pywh4taz5n/workbench-desk-robot/hardware/pcb/fabrication/drill-report.txt

Drill report for controller.kicad_pcb
Created on 2026-08-25T17:45:02

Copper Layer Stackup:
    =============================================================
    L1 :  F.Cu                      front
    L2 :  In1.Cu                    in1
    L3 :  In2.Cu                    in2
    L4 :  In3.Cu                    in3
    L5 :  In4.Cu                    in4
    L6 :  In5.Cu                    in5
    L7 :  In6.Cu                    in6
    L8 :  B.Cu                      back

Drill file 'controller-PTH.drl' contains
    plated through holes:
    =============================================================
    T1  0.300mm  0.0118"  (150 holes))
    T2  0.400mm  0.0157"  (56 holes))
    T3  1.000mm  0.0394"  (48 holes))
    T4  1.100mm  0.0433"  (32 holes))
    T5  1.200mm  0.0472"  (2 holes))
    T6  1.300mm  0.0512"  (6 holes))
    T7  1.800mm  0.0709"  (2 holes))

    Total plated holes count 296

Drill file 'controller-front-in1.drl' contains
    holes connecting layer pair: 'F.Cu and In1.Cu' (blind vias):
    =============================================================
    T1  0.150mm  0.0059"  (9 holes))
    T2  0.300mm  0.0118"  (2 holes))

    Total plated holes count 11

Drill file 'controller-front-in2.drl' contains
    holes connecting layer pair: 'F.Cu and In2.Cu' (blind vias):
    =============================================================
    T1  0.300mm  0.0118"  (1 hole)

    Total plated holes count 1

Drill file 'controller-front-in3.drl' contains
    holes connecting layer pair: 'F.Cu and In3.Cu' (blind vias):
    =============================================================
    T1  0.300mm  0.0118"  (4 holes))

    Total plated holes count 4

Drill file 'controller-NPTH.drl' contains
    unplated through holes:
    =============================================================
    T1  3.200mm  0.1260"  (4 holes))

    Total unplated holes count 4
