pywh4taz5n/workbench-desk-robot/hardware/pcb/fabrication/board-preview.png

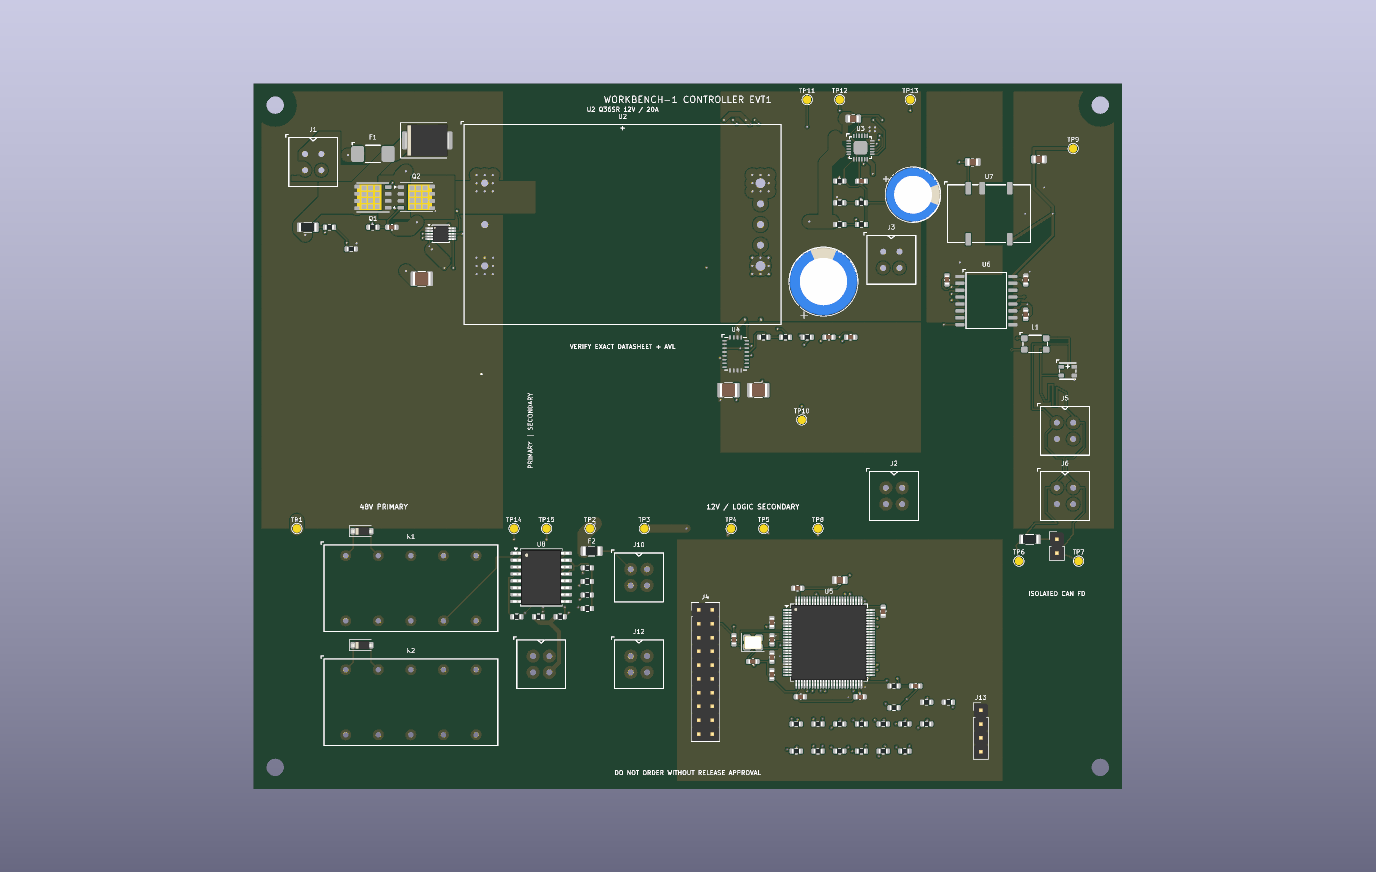
hardware/pcb/fabrication/board-preview.png
