pywh4taz5n/workbench-desk-robot/hardware/pcb/fabrication/drawings/controller-schematic.pdf

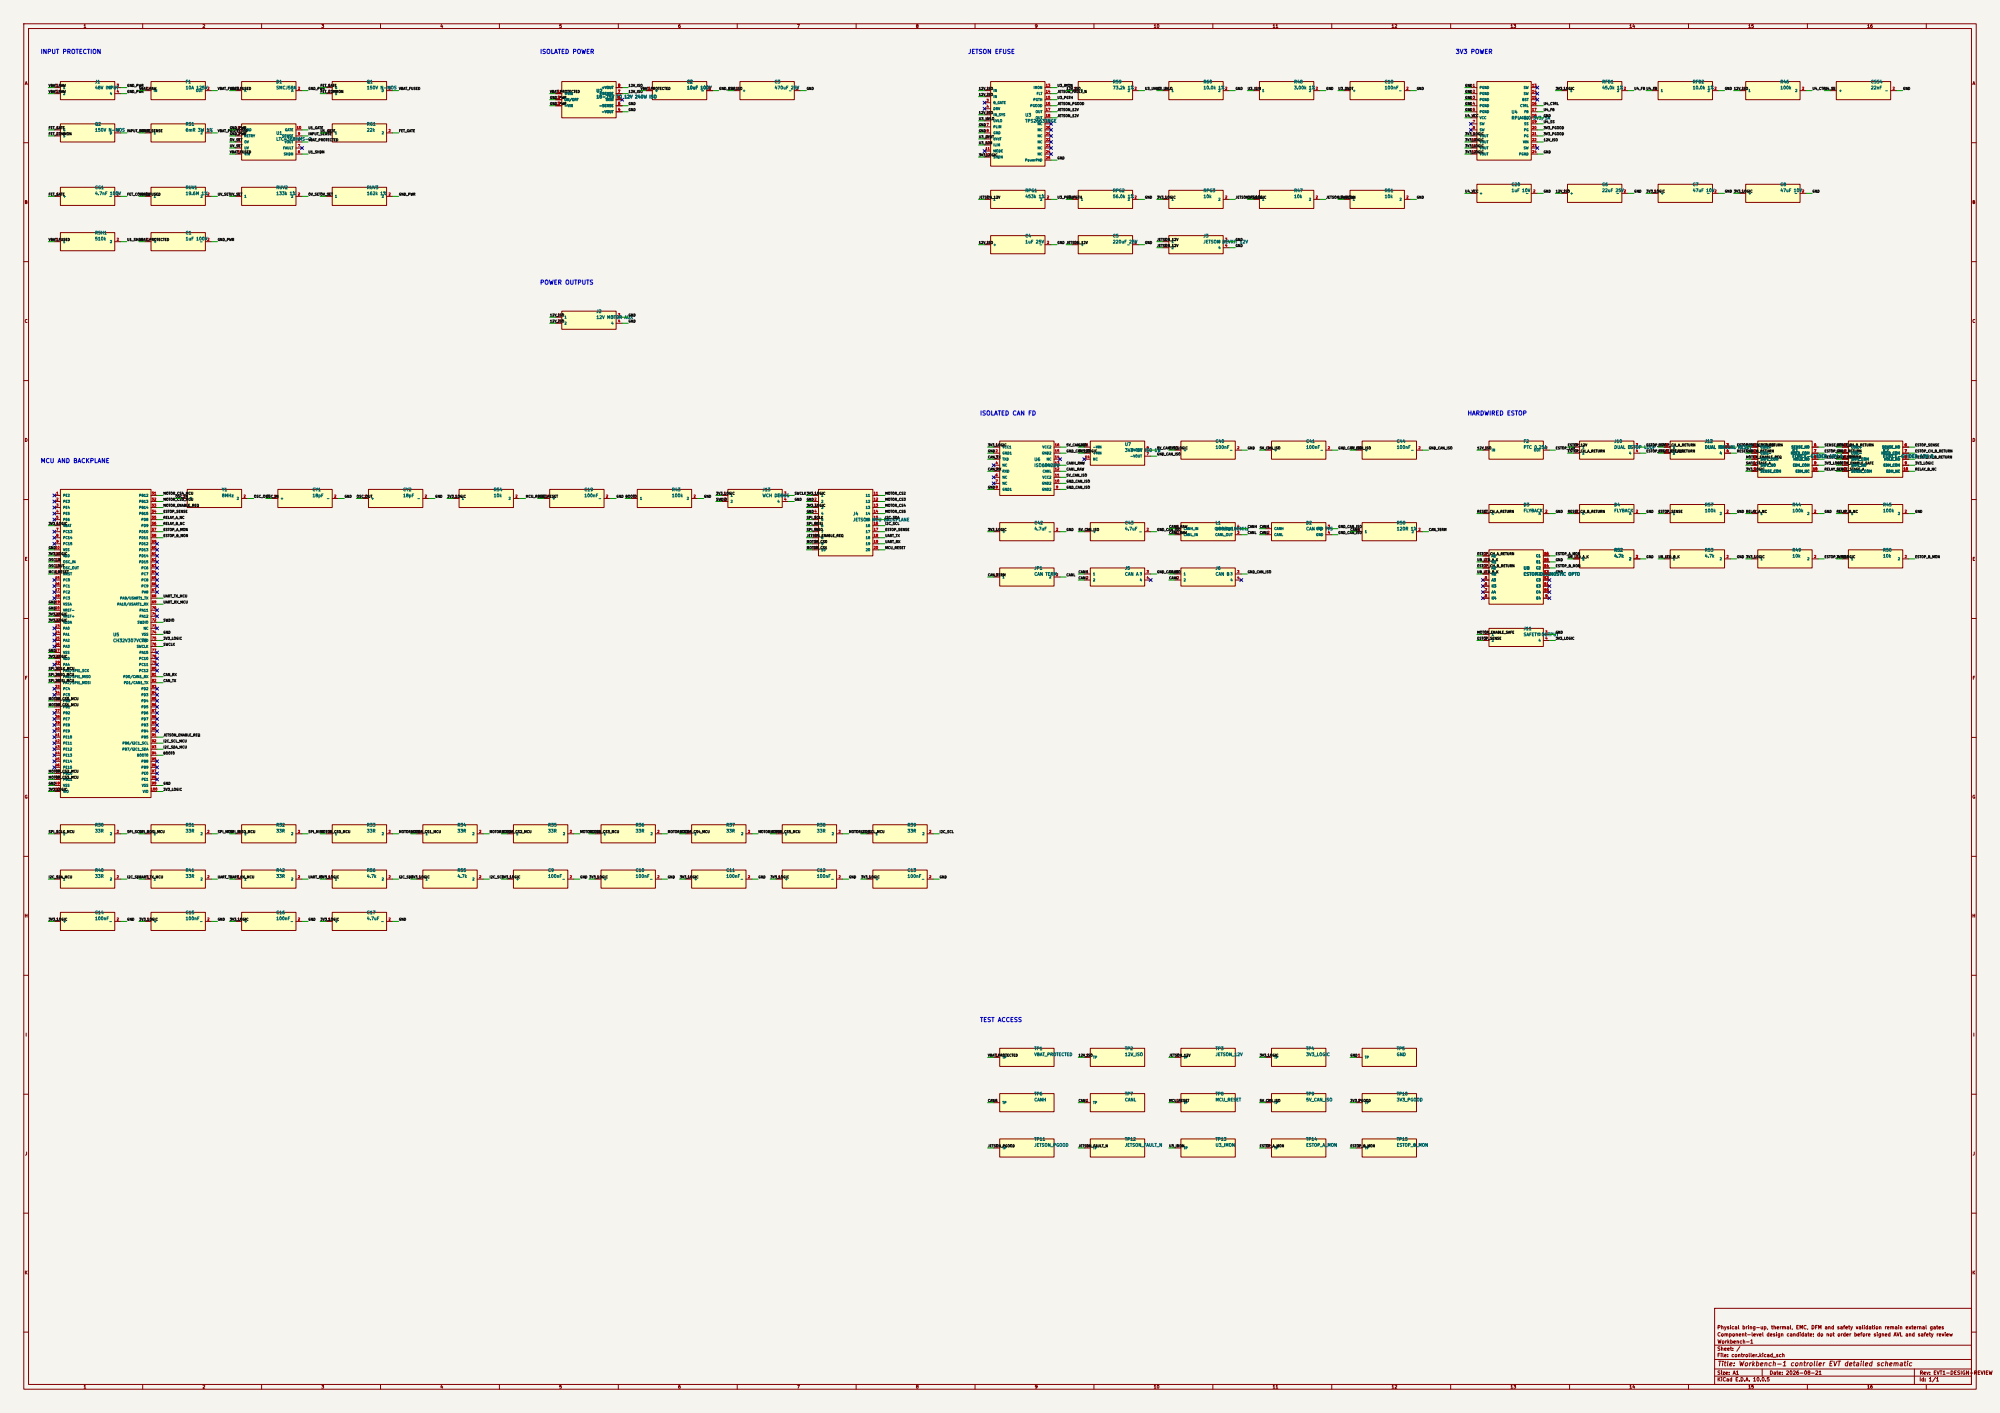
[picture p2: page 1]

Physical bring-up, thermal, EMC, DFM and safety validation remain external gates
Component-level design candidate; do not order before signed AVL and safety review
Workbench-1
Sheet: /
File: controller.kicad_sch
Title: Workbench-1 controller EVT detailed schematic
