pywh4taz5n/workbench-desk-robot/hardware/pcb/fabrication/drawings/routing-review.pdf

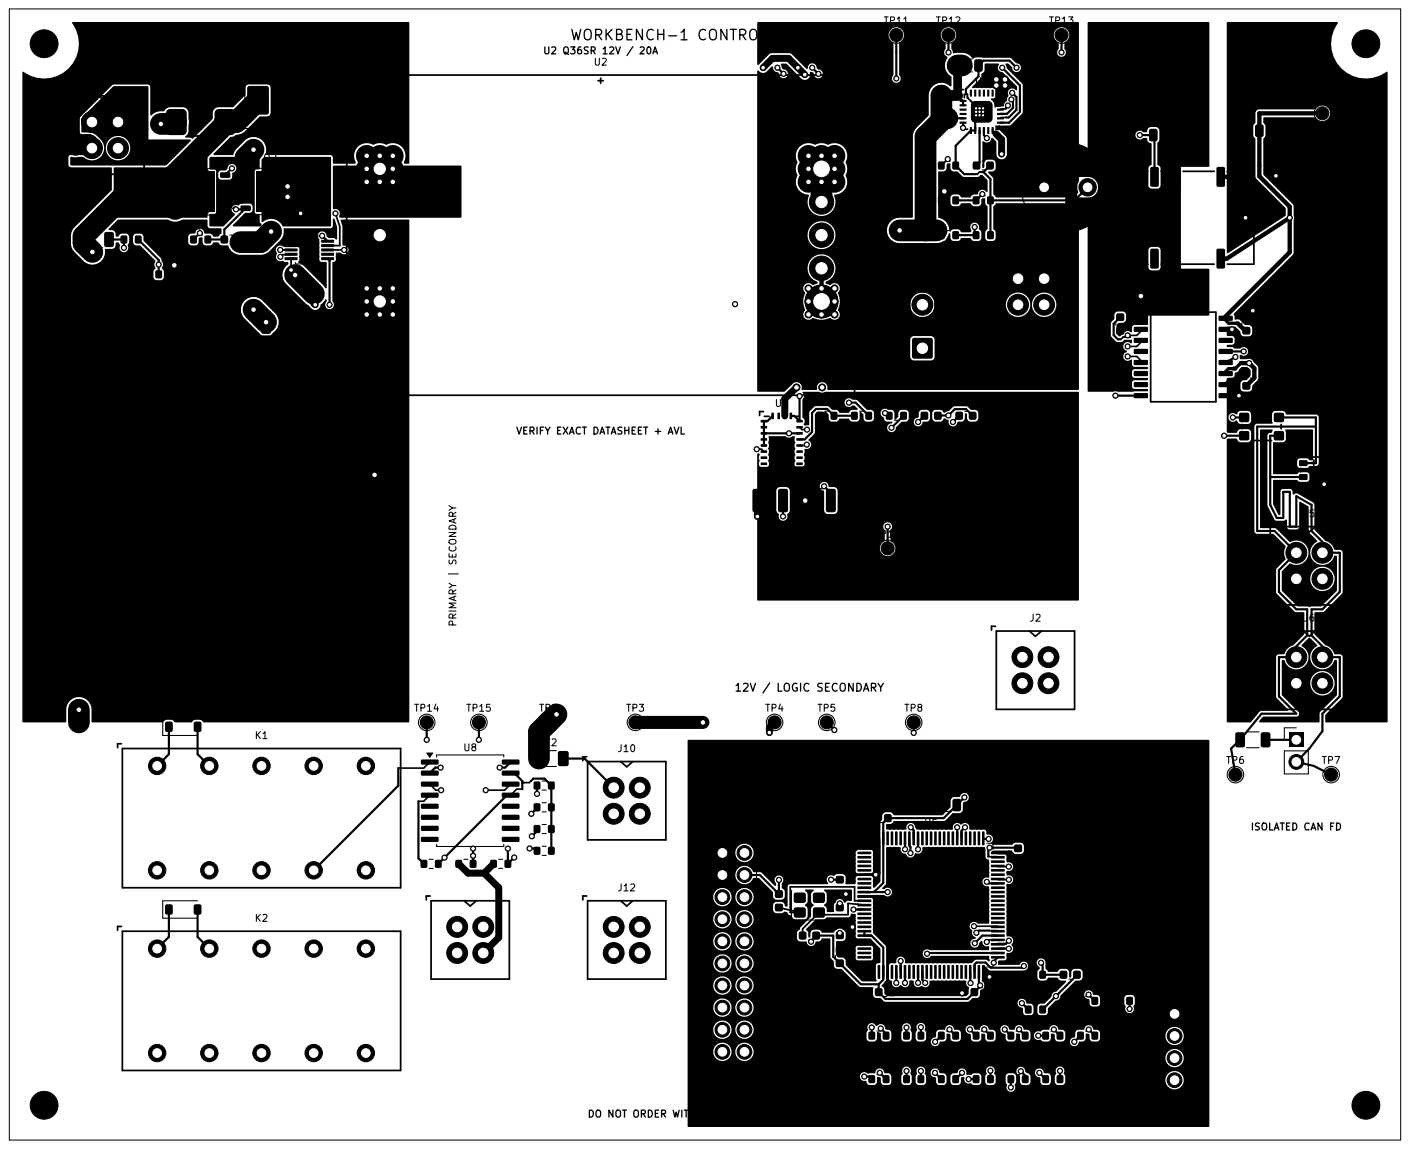
[picture p4: page 1]

VERIFY EXACT DATASHEET + AVL WORKBENCH-1 CONTROLLER EVT1
