pywh4taz5n/workbench-desk-robot/(list of files, drawings)

Other design files:
docs/task_packets/pcb-detailed-design-readiness.json
