pywh4taz5n/workbench-desk-robot/hardware/pcb/kicad/controller.kicad_pcb

## KiCad design hardware/pcb/kicad/controller.kicad_pcb (2026-08-25)

Schematic: controller.kicad_sch, Workbench-1 controller EVT detailed schematic

Parts:
C1: 1uF 100V; C_1210_3225Metric
C2: 10uF 100V; C_2220_5750Metric
C3: 470uF 25V; CP_Radial_D12.5mm_P5.00mm
C4: 1uF 25V; C_0805_2012Metric
C5: 220uF 25V; CP_Radial_D10.0mm_P5.00mm
C6: 22uF 25V; C_1210_3225Metric
C7, C8: 47uF 10V; C_1210_3225Metric
C9, C10, C11, C12, C13, C14, C15, C16, C18, C19, C40, C41, C44: 100nF; C_0603_1608Metric
C17, C42, C43: 4.7uF; C_0805_2012Metric
C20: 1uF 10V; C_0603_1608Metric
CG1: 4.7nF 100V; C_0603_1608Metric
CSS4: 22nF; C_0603_1608Metric
CY1, CY2: 18pF; C_0603_1608Metric
D1: SMCJ58A; D_SMC; MPN Littelfuse SMCJ58A
D2: CAN FD TVS; CAN_TVS; MPN Nexperia PESD2CANFD24V-T
D3, D4: FLYBACK; D_SOD-123; MPN Diodes Inc. 1N4148W-7-F
F1: 10A 125V; Fuse_4510; MPN Littelfuse 0451010.MRL
F2: PTC 0.25A; Fuse_1206_3216Metric; MPN Littelfuse 1206L025YR
J1: 48V INPUT; MicroFit_2x2; MPN Molex 43045-0412
J2: 12V MOTOR AUX; MicroFit_2x2; MPN Molex 43045-0412
J3: JETSON DEVKIT 12V; MicroFit_2x2; MPN Molex 43045-0412
J4: JETSON MCU BACKPLANE; PinHeader_2x10_P2.54mm_Vertical
J5: CAN A; MicroFit_2x2; MPN Molex 43045-0412
J6: CAN B; MicroFit_2x2; MPN Molex 43045-0412
J10: DUAL ESTOP LOOP; MicroFit_2x2; MPN Molex 43045-0412
J11: SAFETY OUTPUT; MicroFit_2x2; MPN Molex 43045-0412
J12: DUAL MANUAL RESET; MicroFit_2x2; MPN Molex 43045-0412
J13: WCH DEBUG; PinHeader_1x04_P2.54mm_Vertical
JP1: CAN TERM; PinHeader_1x02_P2.54mm_Vertical
K1: FORCE-GUIDED 12V A; Panasonic_SFM4; MPN Panasonic SFM4-DC12V
K2: FORCE-GUIDED 12V B; Panasonic_SFM4; MPN Panasonic SFM4-DC12V
L1: 100R@100MHz; ACT45B; MPN TDK ACT45B-101-2P-TL003
Q1, Q2: 150V N-MOS; Infineon_PG-TDSON-8_6.15x5.15mm; MPN Infineon BSC093N15NS5ATMA1
R30, R31, R32, R33, R34, R35, R36, R37, R38, R39, R40, R41, R42: 33R; R_0603_1608Metric
R43, R44, R45, R46, R57: 100k; R_0603_1608Metric
R47, R49, R50, R51, R54: 10k; R_0603_1608Metric
R48: 3.00k 1%; R_0603_1608Metric
R52, R53, R55, R56: 4.7k; R_0603_1608Metric
R58: 120R 1%; R_1206_3216Metric
R59: 73.2k 1%; R_0603_1608Metric
R60: 10.0k 1%; R_0603_1608Metric
RFB1: 45.0k 1%; R_0603_1608Metric
RFB2: 10.0k 1%; R_0603_1608Metric
RG1: 22k; R_0603_1608Metric
RPG1: 453k 1%; R_0603_1608Metric
RPG2: 56.0k 1%; R_0603_1608Metric
RPG3: 10k; R_0603_1608Metric
RS1: 6mR 3W 1%; Sense_3637; MPN Vishay WSL3637R0060FEA
RSH1: 510k; R_0603_1608Metric
RUV1: 19.6M 1%; R_1206_3216Metric
RUV2: 133k 1%; R_0603_1608Metric
RUV3: 162k 1%; R_0603_1608Metric
TP1: VBAT_PROTECTED; TestPoint_Pad_D1.5mm
TP2: 12V_ISO; TestPoint_Pad_D1.5mm
TP3: JETSON_12V; TestPoint_Pad_D1.5mm
TP4: 3V3_LOGIC; TestPoint_Pad_D1.5mm
TP5: GND; TestPoint_Pad_D1.5mm
TP6: CANH; TestPoint_Pad_D1.5mm
TP7: CANL; TestPoint_Pad_D1.5mm
TP8: MCU_RESET; TestPoint_Pad_D1.5mm
TP9: 5V_CAN_ISO; TestPoint_Pad_D1.5mm
TP10: 3V3_PGOOD; TestPoint_Pad_D1.5mm
TP11: JETSON_PGOOD; TestPoint_Pad_D1.5mm
TP12: JETSON_FAULT_N; TestPoint_Pad_D1.5mm
TP13: U3_IMON; TestPoint_Pad_D1.5mm
TP14: ESTOP_A_MON; TestPoint_Pad_D1.5mm
TP15: ESTOP_B_MON; TestPoint_Pad_D1.5mm
U1: LTC4368HMS-2; MSOP-10_3x3mm_P0.5mm; MPN LTC4368HMS-2#PBF
U2: 18-75V TO 12V 240W ISO; Delta_Q36SR_QuarterBrick; MPN Q36SR12020NRFH
U3: TPS26633RGE; TPS26633_RGE24; MPN Texas Instruments TPS26633RGER
U4: RPL-5.0 3V3/5A; RPL-5.0_QFN24; MPN RECOM RPL-5.0-R
U5: CH32V307VCT6; LQFP-100_14x14mm_P0.5mm; MPN WCH CH32V307VCT6
U6: ISO1042DW; ISO1042_DW16_HV; MPN Texas Instruments ISO1042DWR
U7: 3V3-5V ISO 1W; Murata_NXF1_MC; MPN NXF1S0305MC-R7
U8: ESTOP DIAGNOSTIC OPTO; SOIC-16W_7.5x10.3mm_P1.27mm; MPN Toshiba TLP293-4(GB,E)
Y1: 8MHz; Crystal_SMD_3225-4Pin_3.2x2.5mm; MPN Abracon ABM8-8.000MHZ-B2-T

Connections:
3V3_LOGIC: C7.1 (+), C8.1 (+), C9.1 (+), C10.1 (+), C11.1 (+), C12.1 (+), C13.1 (+), C14.1 (+), C15.1 (+), C16.1 (+), C17.1 (+), C40.1 (+), C42.1 (+), J4.1, J4.3, J11.4, J13.1, K1.5 (SENSE_COM), K1.9 (EDM_COM), K2.9 (EDM_COM), R47.1, R49.1, R50.1, R54.1, R55.1, R56.1, RFB1.1, RPG3.1, TP4.1, U3.12 (SHDN), U4.9 (VOUT), U4.10 (VOUT), U4.11 (VOUT), U4.12 (VOUT), U5.6 (VBAT), U5.11 (VDD), U5.21 (VREF+), U5.22 (VDDA), U5.28 (VDD), U5.50 (VIO), U5.75 (VDD), U5.100 (VIO), U6.1 (VCC1), U7.3 (+VIN)
3V3_PGOOD: TP10.1, U4.20 (PG), U4.21 (PG)
5V_CAN_ISO: C41.1 (+), C43.1 (+), C44.1 (+), TP9.1, U6.11 (VCC2), U6.16 (VCC2), U7.8 (+VOUT)
12V_ISO: C3.1 (+), C4.1 (+), C6.1 (+), F2.1 (IN), J2.1, J2.2, R46.1, R59.1, TP2.1, U2.7 (+SENSE), U2.8 (+VOUT), U3.1 (IN), U3.2 (IN), U3.5 (IN_SYS), U4.22 (VIN)
BOOT0: R43.1, U5.94 (BOOT0)
CANH: D2.1 (CANH), J5.1, J6.1, L1.4 (CANH_OUT), R58.1, TP6.1
CANH_RAW: L1.1 (CANH_IN), U6.13 (CANH)
CANL: D2.2 (CANL), J5.2, J6.2, JP1.2, L1.3 (CANL_OUT), TP7.1
CANL_RAW: L1.2 (CANL_IN), U6.12 (CANL)
CAN_RX: U5.81 (PD0/CAN1_RX), U6.5 (RXD)
CAN_TERM: JP1.1, R58.2
CAN_TX: U5.82 (PD1/CAN1_TX), U6.3 (TXD)
ESTOP_12V: F2.2 (OUT), J10.1, J10.3
ESTOP_A_MON: R49.2, TP14.1, U5.57 (PD10), U8.16 (C1)
ESTOP_B_MON: R50.2, TP15.1, U5.58 (PD11), U8.14 (C2)
ESTOP_CH_A_RETURN: J10.2, J12.1, K1.7 (HOLD_COM), U8.1 (A1)
ESTOP_CH_B_RETURN: J10.4, J12.3, K2.7 (HOLD_COM), U8.3 (A2)
ESTOP_SENSE: J4.17, J11.2, K2.6 (SENSE_NO), R57.1, U5.54 (PB15)
GND: C3.2 (-), C4.2 (-), C5.2 (-), C6.2 (-), C7.2 (-), C8.2 (-), C9.2 (-), C10.2 (-), C11.2 (-), C12.2 (-), C13.2 (-), C14.2 (-), C15.2 (-), C16.2 (-), C17.2 (-), C18.2 (-), C19.2 (-), C20.2 (-), C40.2 (-), C42.2 (-), CSS4.2 (-), CY1.2 (-), CY2.2 (-), D3.2 (A), D4.2 (A), J2.3, J2.4, J3.3, J3.4, J4.2, J4.4, J11.3, J13.4, K1.2 (COIL-), K2.2 (COIL-), R43.2, R44.2, R45.2, R48.2, R51.2, R52.2, R53.2, R57.2, R60.2, RFB2.2, RPG2.2, TP5.1, U2.4 (-VOUT), U2.5 (-SENSE), U3.7 (PLIM), U3.8 (GND), U3.25 (PowerPAD), U4.1 (PGND), U4.2 (PGND), U4.3 (PGND), U4.4 (PGND), U4.5 (PGND), U4.18 (AGND), U4.24 (PGND), U5.10 (VSS), U5.19 (VSSA), U5.20 (VREF-), U5.27 (VSS), U5.49 (VSS), U5.74 (VSS), U5.99 (VSS), U6.2 (GND1), U6.8 (GND1), U7.1 (-VIN), U8.13 (E2), U8.15 (E1)
GND_CAN_ISO: C41.2 (-), C43.2 (-), C44.2 (-), D2.3 (GND), D2.4 (GND), J5.3, J6.3, U6.9 (GND2), U6.10 (GND2), U6.15 (GND2), U7.7 (-VOUT)
GND_PWR: C1.2 (-), C2.2 (-), D1.2 (A), J1.3, J1.4, RUV3.2, U1.1 (GND), U1.2 (RETRY), U2.2 (ON/OFF), U2.3 (-VIN)
I2C_SCL: J4.16, R39.2, R55.2
I2C_SCL_MCU: R39.1, U5.92 (PB6/I2C1_SCL)
I2C_SDA: J4.15, R40.2, R56.2
I2C_SDA_MCU: R40.1, U5.93 (PB7/I2C1_SDA)
JETSON_12V: C5.1 (+), J3.1, J3.2, RPG1.1, TP3.1, U3.17 (OUT), U3.18 (OUT)
JETSON_ENABLE_REQ: J4.8, U5.91 (PB5)
JETSON_FAULT_N: R47.2, TP12.1, U3.14 (FLT)
JETSON_PGOOD: RPG3.2, TP11.1, U3.16 (PGOOD)
MCU_RESET: C19.1 (+), J4.20, R54.2, TP8.1, U5.14 (NRST)
MOTOR_CS0: J4.9, R33.2
MOTOR_CS0_MCU: R33.1, U5.35 (PB0)
MOTOR_CS1: J4.10, R34.2
MOTOR_CS1_MCU: R34.1, U5.36 (PB1)
MOTOR_CS2: J4.11, R35.2
MOTOR_CS2_MCU: R35.1, U5.47 (PB10)
MOTOR_CS3: J4.12, R36.2
MOTOR_CS3_MCU: R36.1, U5.48 (PB11)
MOTOR_CS4: J4.13, R37.2
MOTOR_CS4_MCU: R37.1, U5.51 (PB12)
MOTOR_CS5: J4.14, R38.2
MOTOR_CS5_MCU: R38.1, U5.52 (PB13)
MOTOR_ENABLE_REQ: K1.3 (SAFE_COM), U5.53 (PB14)
MOTOR_ENABLE_SAFE: J11.1, K2.4 (SAFE_NO)
OSC_IN: CY1.1 (+), U5.12 (OSC_IN), Y1.1
OSC_OUT: CY2.1 (+), U5.13 (OSC_OUT), Y1.2
OV_SET: RUV2.2, RUV3.1, U1.3 (OV)
RELAY_A_NC: K1.10 (EDM_NC), R44.1, U5.55 (PD8)
RELAY_B_NC: K2.10 (EDM_NC), R45.1, U5.56 (PD9)
RESET_CH_A_RETURN: D3.1 (K), J12.2, K1.1 (COIL+), K1.8 (HOLD_NO)
RESET_CH_B_RETURN: D4.1 (K), J12.4, K2.1 (COIL+), K2.8 (HOLD_NO)
SAFE_STAGE_A: K1.4 (SAFE_NO), K2.3 (SAFE_COM)
SENSE_STAGE_A: K1.6 (SENSE_NO), K2.5 (SENSE_COM)
SPI_MISO: J4.7, R32.2
SPI_MISO_MCU: R32.1, U5.31 (PA6/SPI1_MISO)
SPI_MOSI: J4.6, R31.2
SPI_MOSI_MCU: R31.1, U5.32 (PA7/SPI1_MOSI)
SPI_SCLK: J4.5, R30.2
SPI_SCLK_MCU: R30.1, U5.30 (PA5/SPI1_SCK)
SWCLK: J13.3, U5.76 (SWCLK)
SWDIO: J13.2, U5.72 (SWDIO)
U1_GATE: RG1.1, U1.10 (GATE)
U1_SHDN: RSH1.2, U1.6 (SHDN)
U3_DVDT: C18.1 (+), U3.9 (dVdT)
U3_ILIM: R48.1, U3.10 (ILIM)
U3_IMON: R51.1, TP13.1, U3.13 (IMON)
U3_PGTH: RPG1.2, RPG2.1, U3.15 (PGTH)
U3_UVLO: R59.2, R60.1, U3.6 (UVLO)
U4_CTRL: R46.2, U4.16 (CTRL)
U4_FB: RFB1.2, RFB2.1, U4.17 (FB)
U4_SS: CSS4.1 (+), U4.19 (SS)
U4_VCC: C20.1 (+), U4.6 (VCC)
U8_LED_A_K: R52.1, U8.2 (K1)
U8_LED_B_K: R53.1, U8.4 (K2)
UART_RX: J4.19, R42.2
UART_RX_MCU: R42.1, U5.69 (PA10/USART1_RX)
UART_TX: J4.18, R41.2
UART_TX_MCU: R41.1, U5.68 (PA9/USART1_TX)
UV_SET: RUV1.2, RUV2.1, U1.4 (UV)
VBAT_PROTECTED: C1.1 (+), C2.1 (+), RS1.2, TP1.1, U1.8 (VOUT), U2.1 (+VIN)
VBAT_RAW: F1.1 (IN), J1.1, J1.2

Notes on the sheet:
INPUT PROTECTION
ISOLATED POWER
JETSON EFUSE
3V3 POWER
POWER OUTPUTS
MCU AND BACKPLANE
ISOLATED CAN FD
HARDWIRED ESTOP
TEST ACCESS

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
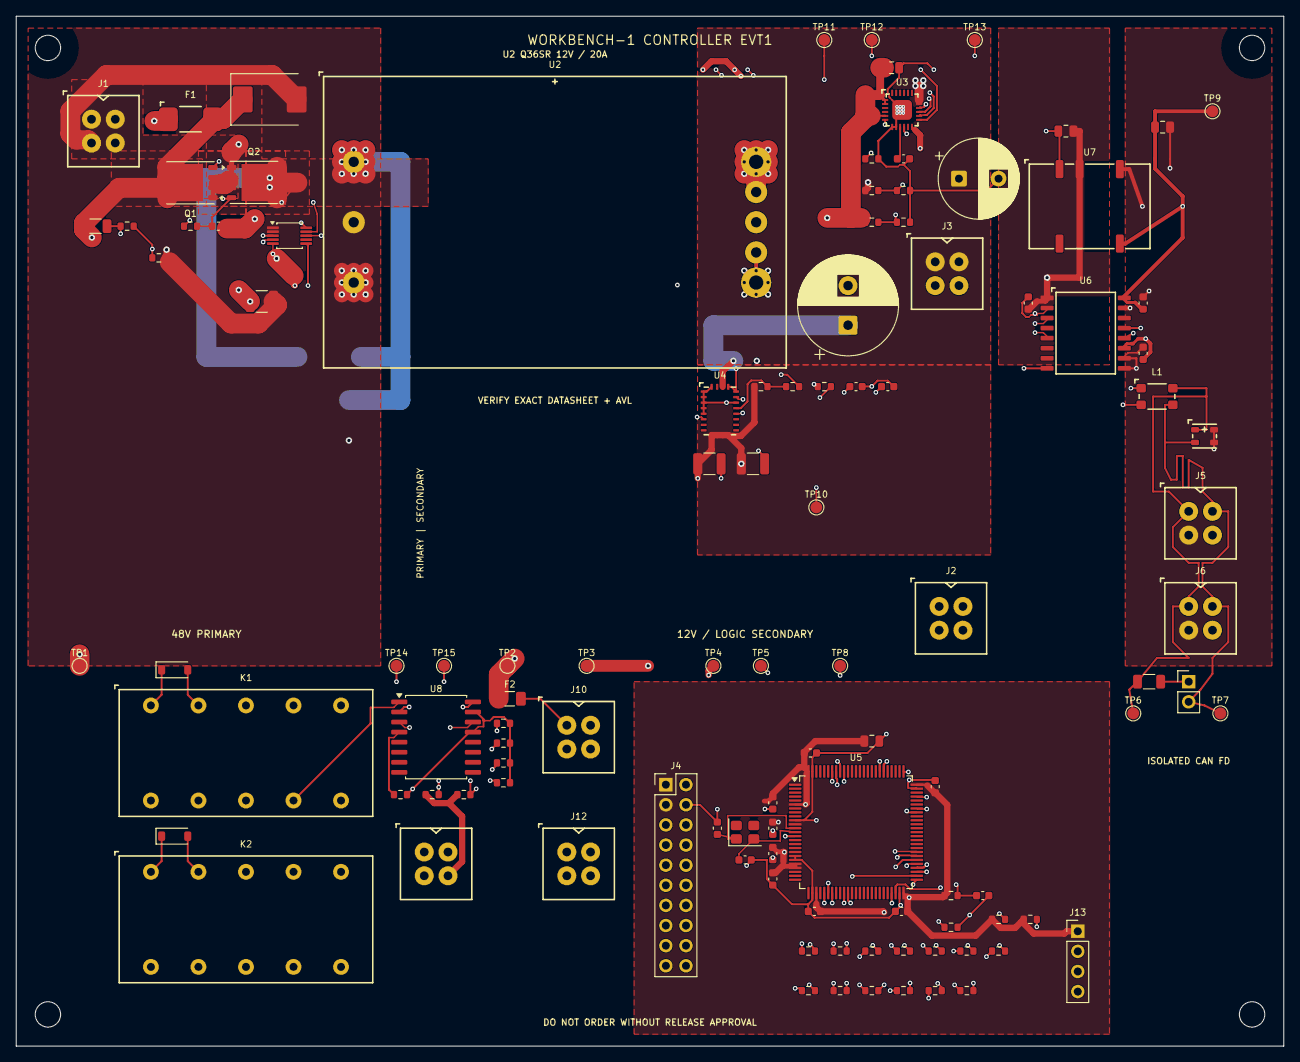
[picture p5: board controller.kicad_pcb from above]

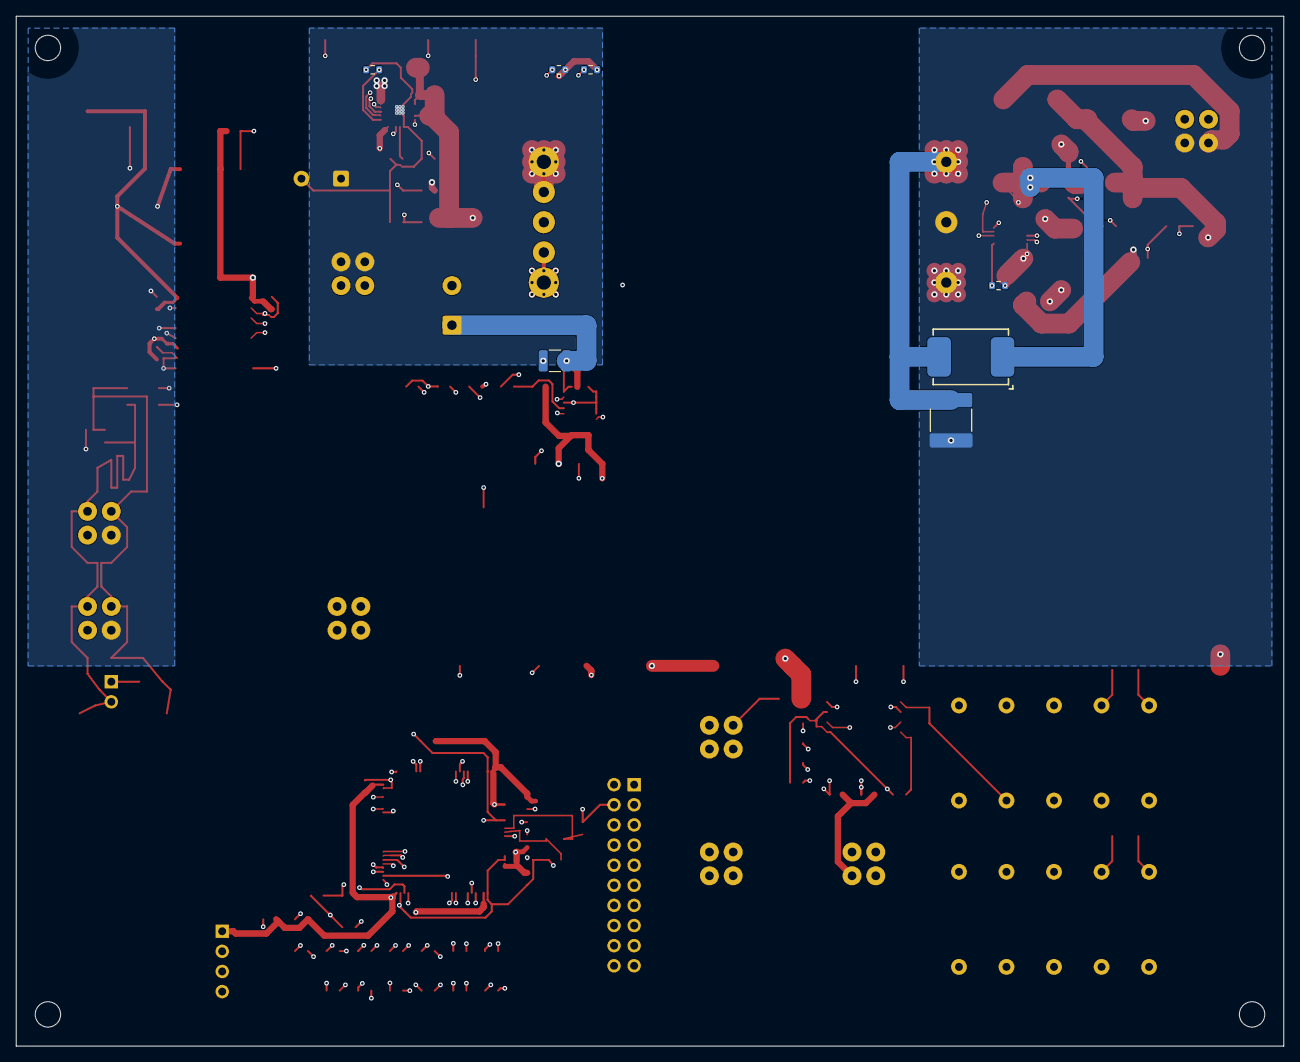
[picture p6: board controller.kicad_pcb from below]

Board: 8 copper layers, 160.0 x 130.0 mm, 121 parts (7 on the bottom side), 85 nets.

Other parts of the board:
H1, H2, H3, H4: M3_NPTH
